Edward-benjamin/Nautilius/Fisico/20251203_213424.jpg

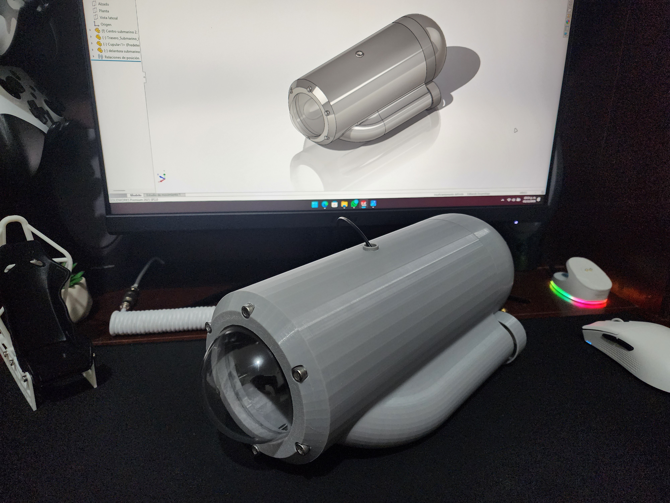
Fisico/20251203_213424.jpg
