Edward-benjamin/Nautilius/Fisico/20251203_213404.jpg

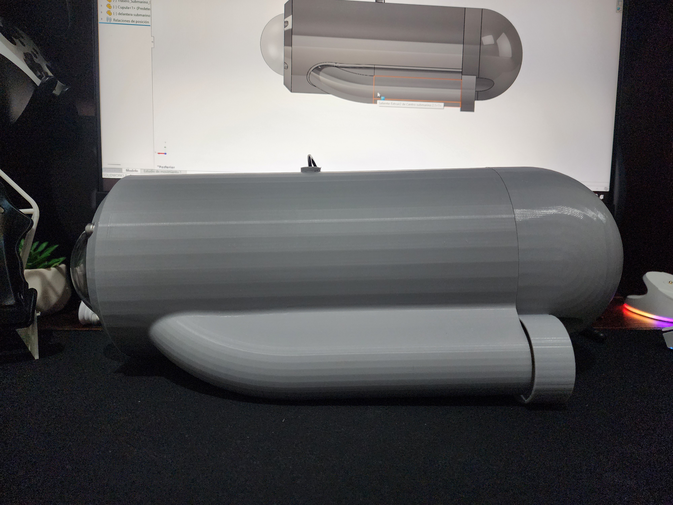
Fisico/20251203_213404.jpg
