Edward-benjamin/Nautilius/Fisico/20251203_213411.jpg

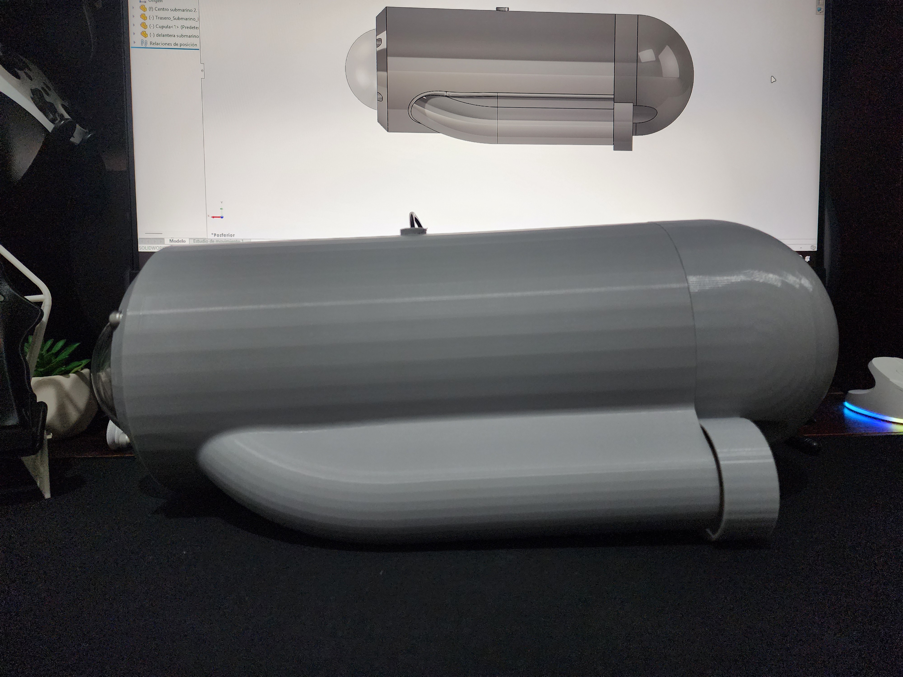
Fisico/20251203_213411.jpg
