Edward-benjamin/Nautilius/Diseño 3D/Submarino completo 4.0.SLDASM

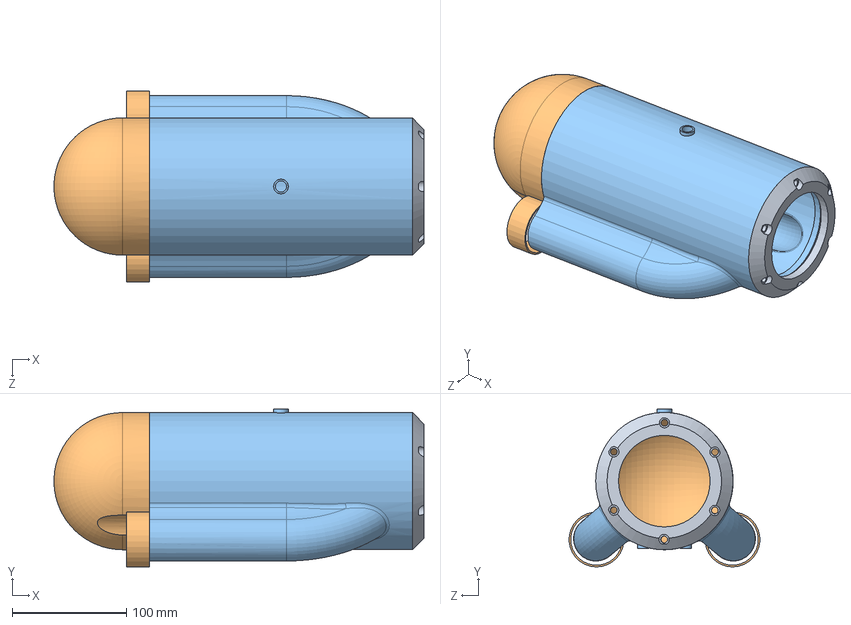
[picture p5: CAD file, 2025-12-01]
Diseño 3D/Submarino completo 4.0.SLDASM
323.4 x 138.0 x 166.8 mm
Centro submarino 2.1
Trasero_Submarino_R3
delantera submarino
