Edward-benjamin/Nautilius/Diseño 3D/Soporte medio de jeringas 2.SLDPRT

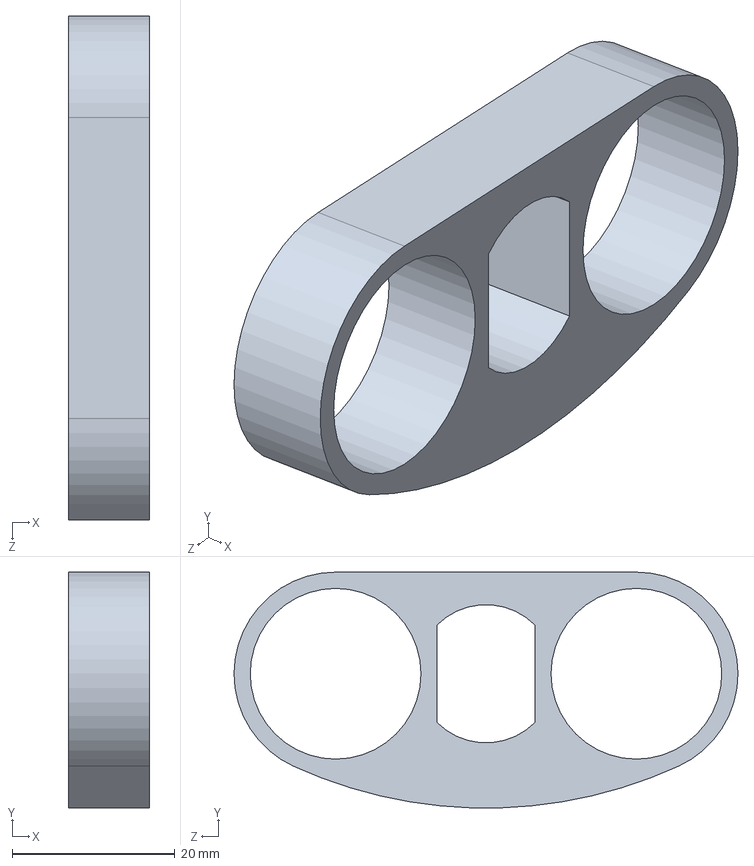
[picture p6: CAD file, 2025-12-01]
Diseño 3D/Soporte medio de jeringas 2.SLDPRT
10.0 x 29.0 x 62.0 mm
