Edward-benjamin/Nautilius/Impresión 3D/Submarino completo 4.0 - delantera submarino-1.STL

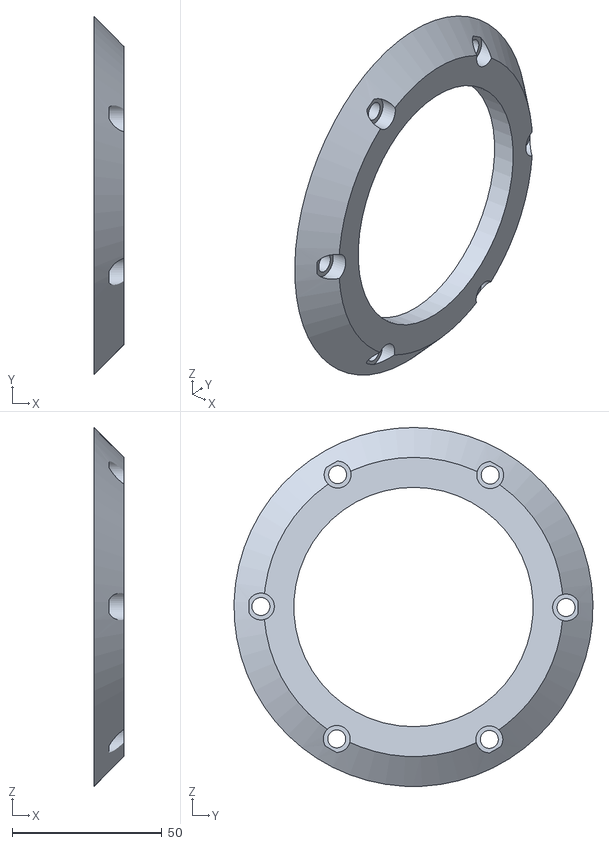
[picture p7: CAD file, 2025-12-04]
Impresión 3D/Submarino completo 4.0 - delantera submarino-1.STL
10.0 x 120.0 x 120.0
