Edward-benjamin/Nautilius/Impresión 3D/Centro submarino 2.1.STL

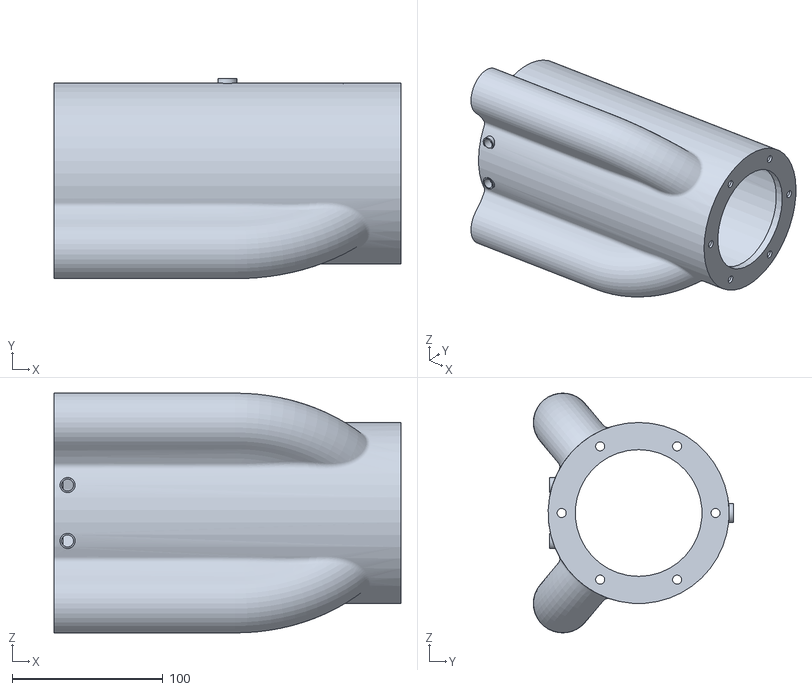
[picture p8: CAD file, 2025-12-04]
Impresión 3D/Centro submarino 2.1.STL
230.0 x 132.8 x 158.9
