Edward-benjamin/Nautilius/Impresión 3D/Submarino completo 4.0 - Trasero_Submarino_R3-1.STL

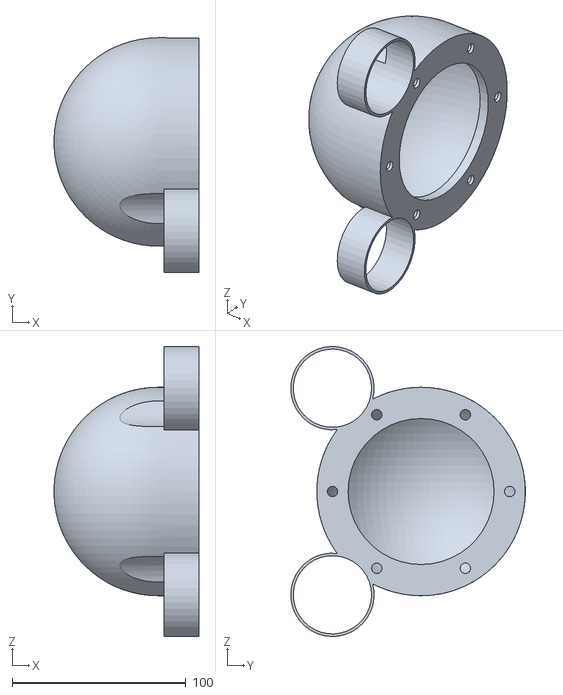
[picture p9: CAD file, 2025-12-04]
Impresión 3D/Submarino completo 4.0 - Trasero_Submarino_R3-1.STL
83.4 x 134.9 x 166.9
