Edward-benjamin/Nautilius/Diseño 3D/Submarino completo.SLDPRT

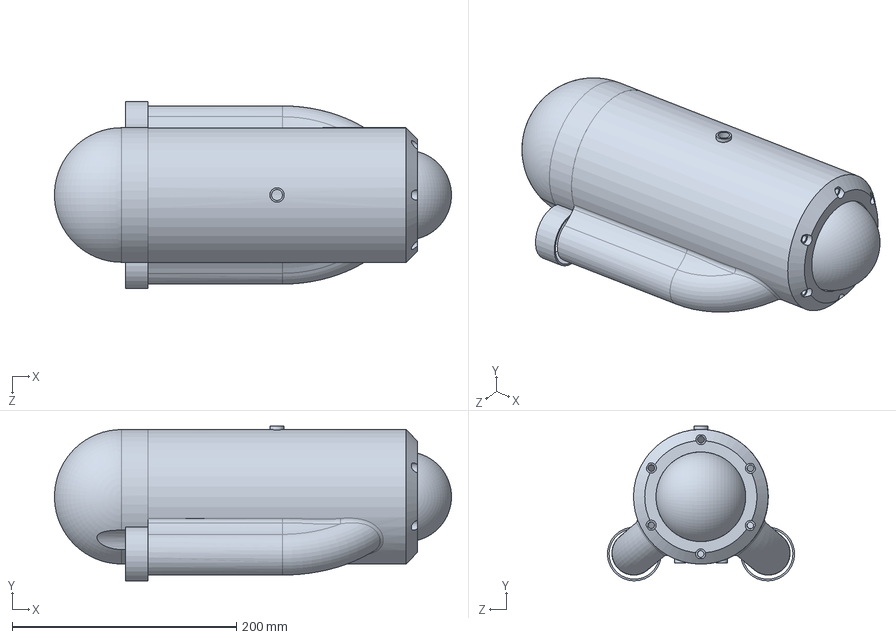
[picture p10: CAD file, 2025-12-01]
Diseño 3D/Submarino completo.SLDPRT
353.9 x 138.0 x 166.8 mm
