Edward-benjamin/Nautilius/(list of files, cad)

Other CAD files:
Diseño 3D/delantera submarino.SLDPRT
Diseño 3D/Trasero_Submarino_R3.SLDPRT
Diseño 3D/Centro submarino 2.1.SLDPRT
Diseño 3D/Submarino completo.SLDDRW
