Edward-benjamin/Nautilius/Diseño 3D/Submarino completo.pdf

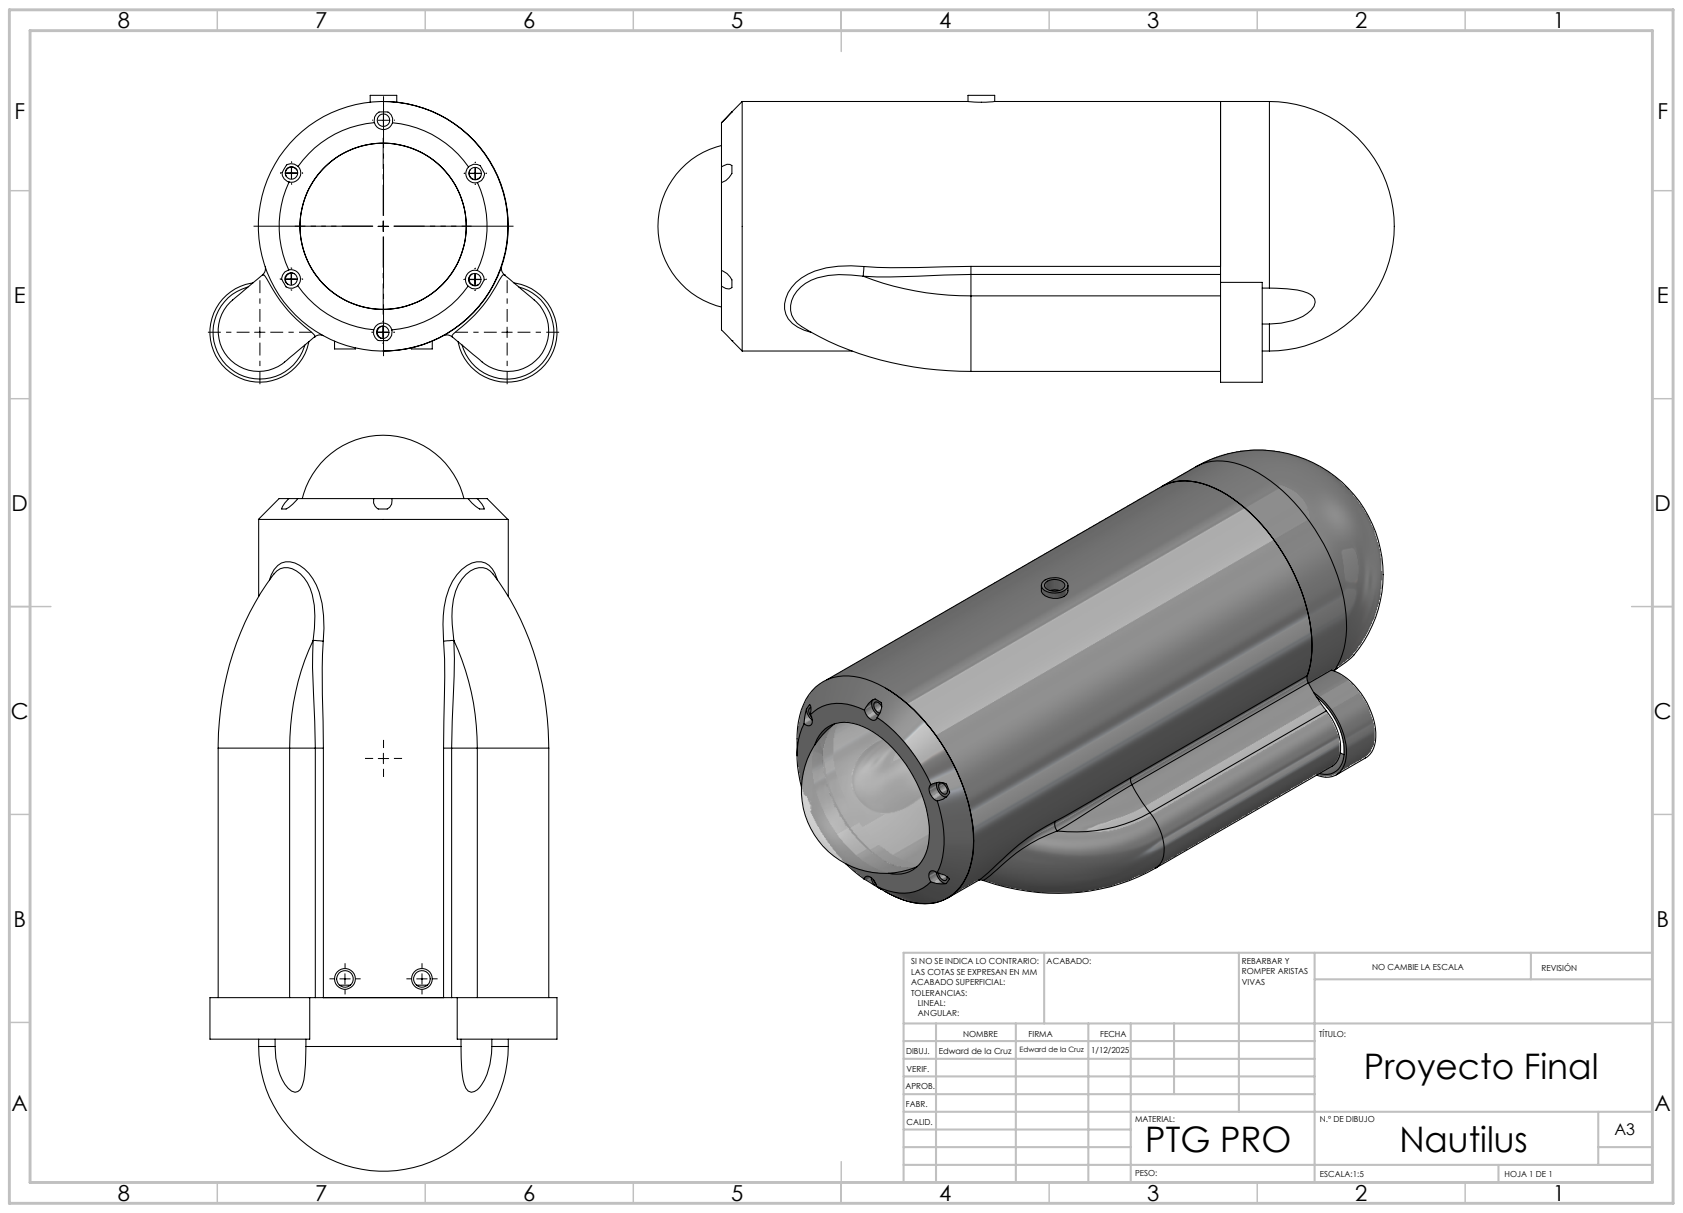
[picture p11: page 1]
ACABADO:; REBARBAR Y; ROMPER ARISTAS; NO CAMBIE LA ESCALA; REVISIÓN; ESCALA:1:5; HOJA 1 DE 1

SI NO SE INDICA LO CONTRARIO:
LAS COTAS SE EXPRESAN EN MM
ACABADO SUPERFICIAL:
TOLERANCIAS:
LINEAL:
ANGULAR:

NOMBRE | FIRMA | FECHA | | | | TÍTULO:

DIBUJ. | Edward de la Cruz | | 1/12/2025 | | | | Proyecto Final Edward de la Cruz

VERIF.
APROB.
FABR.
CALID. | | | | MATERIAL: PTG PRO | N.º DE DIBUJO Nautilus | A3
