Edward-benjamin/Nautilius/PCB/Submarino.kicad_pcb

## KiCad design PCB/Submarino.kicad_pcb (2025-12-01)

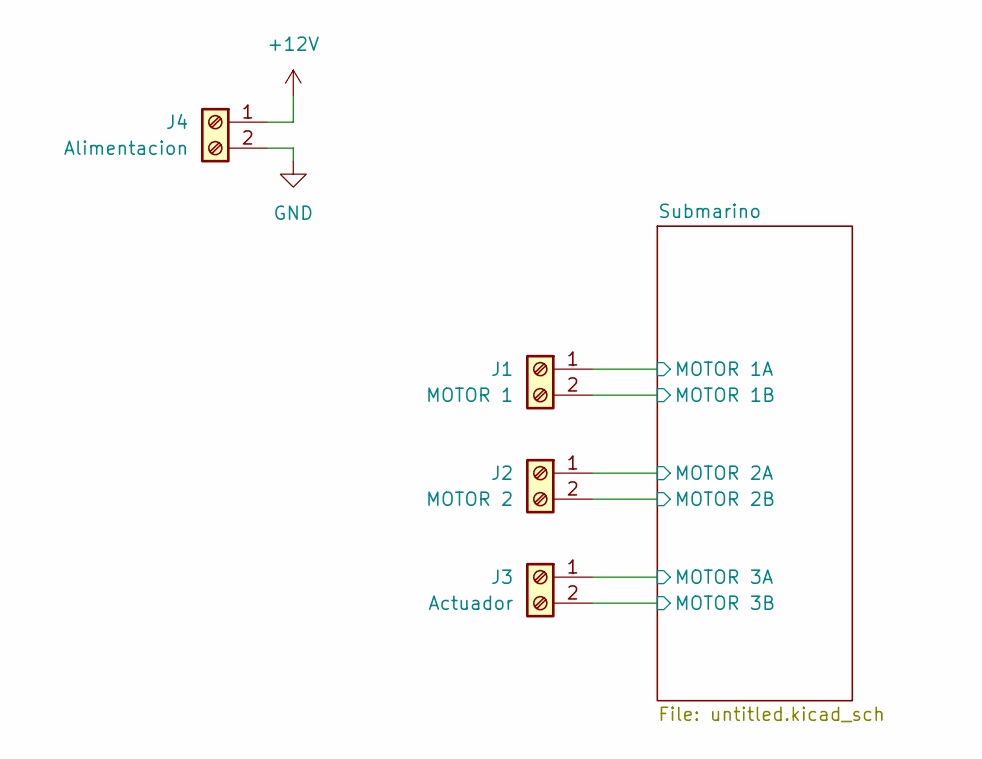
[picture p12: schematic Submarino.kicad_sch]

Parts:
J1: MOTOR 1; Molex_KK-254_AE-6410-02A_1x02_P2.54mm_Vertical
J2: MOTOR 2; Molex_KK-254_AE-6410-02A_1x02_P2.54mm_Vertical
J3: Actuador; Molex_KK-254_AE-6410-02A_1x02_P2.54mm_Vertical
J4: Alimentacion; Molex_KK-254_AE-6410-02A_1x02_P2.54mm_Vertical

Connections:
+12V: J4.1; also elsewhere on the board
/Submarino/MOTOR 1A: J1.1; also elsewhere on the board
/Submarino/MOTOR 1B: J1.2; also elsewhere on the board
/Submarino/MOTOR 2A: J2.1; also elsewhere on the board
/Submarino/MOTOR 2B: J2.2; also elsewhere on the board
/Submarino/MOTOR 3A: J3.1; also elsewhere on the board
/Submarino/MOTOR 3B: J3.2; also elsewhere on the board
GND: J4.2; also elsewhere on the board

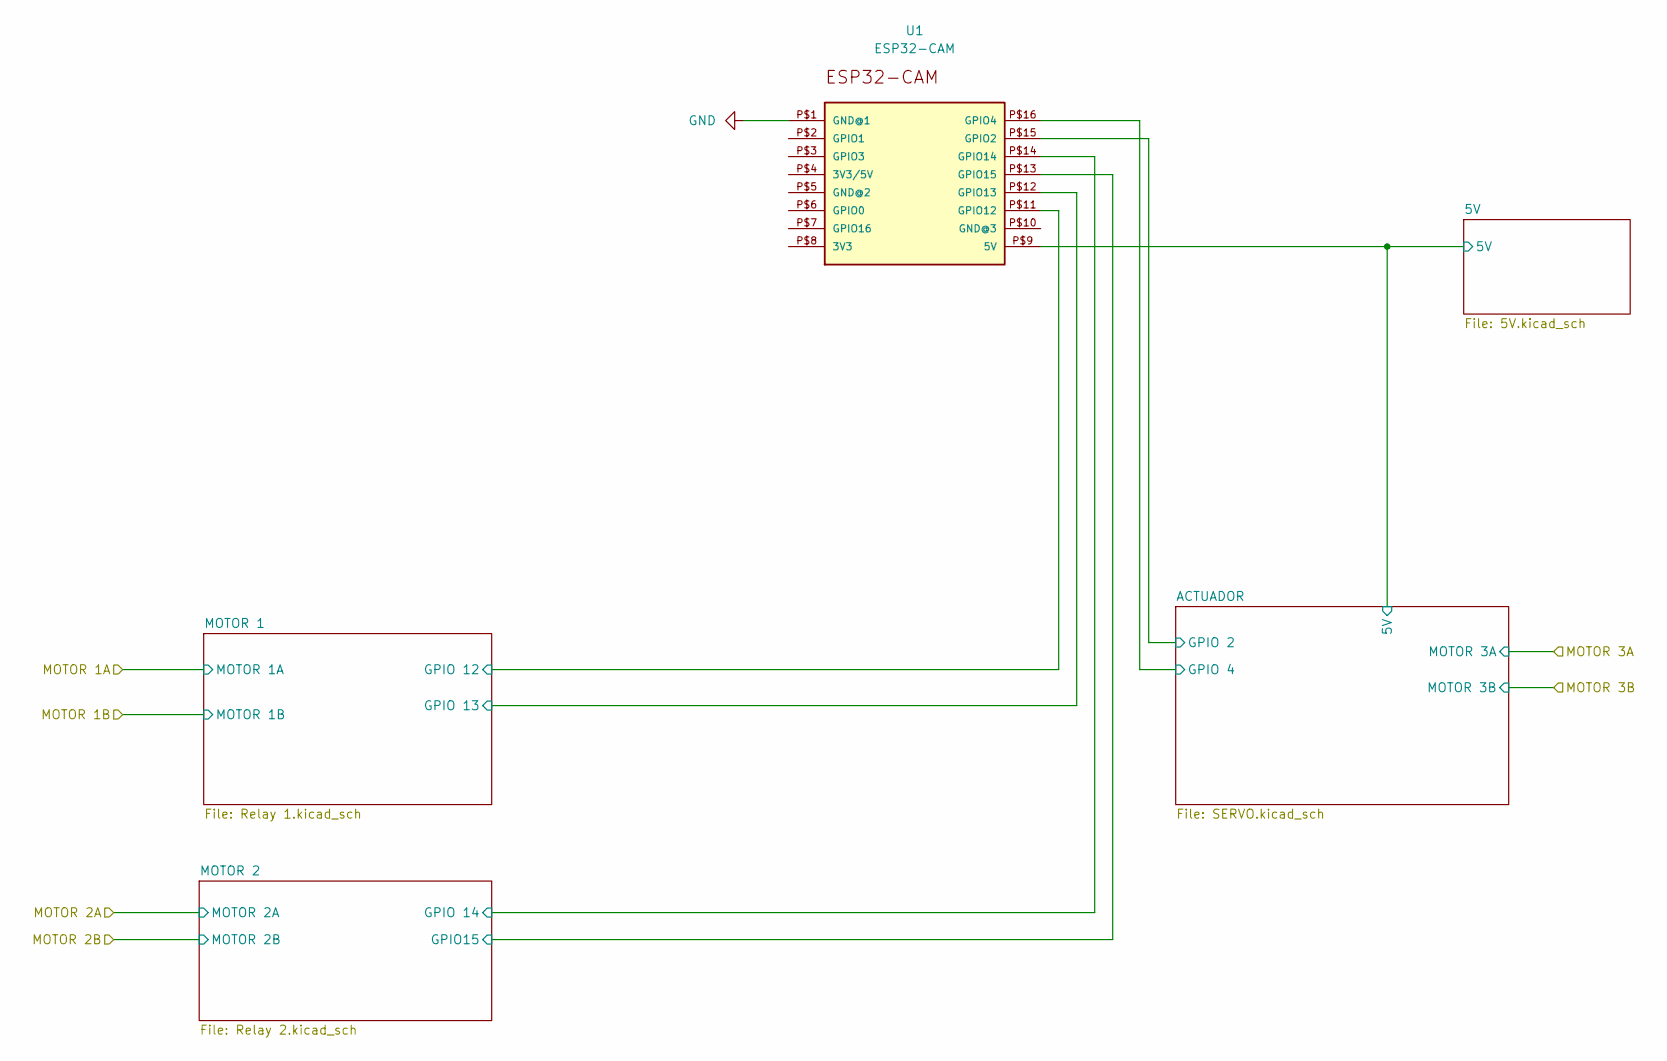
[picture p13: schematic untitled.kicad_sch]

Parts:
U1: ESP32-CAM

Connections:
/Submarino/5V/5V: U1.P$9 (5V); also elsewhere on the board
/Submarino/ACTUADOR/GPIO 2: U1.P$15 (GPIO2); also elsewhere on the board
/Submarino/ACTUADOR/GPIO 4: U1.P$16 (GPIO4); also elsewhere on the board
/Submarino/MOTOR 1/GPIO 12: U1.P$11 (GPIO12); also elsewhere on the board
/Submarino/MOTOR 1/GPIO 13: U1.P$12 (GPIO13); also elsewhere on the board
/Submarino/MOTOR 2/GPIO15: U1.P$13 (GPIO15); also elsewhere on the board
/Submarino/MOTOR 2/GPIO 14: U1.P$14 (GPIO14); also elsewhere on the board
GND: U1.P$1 (GND@1); also elsewhere on the board

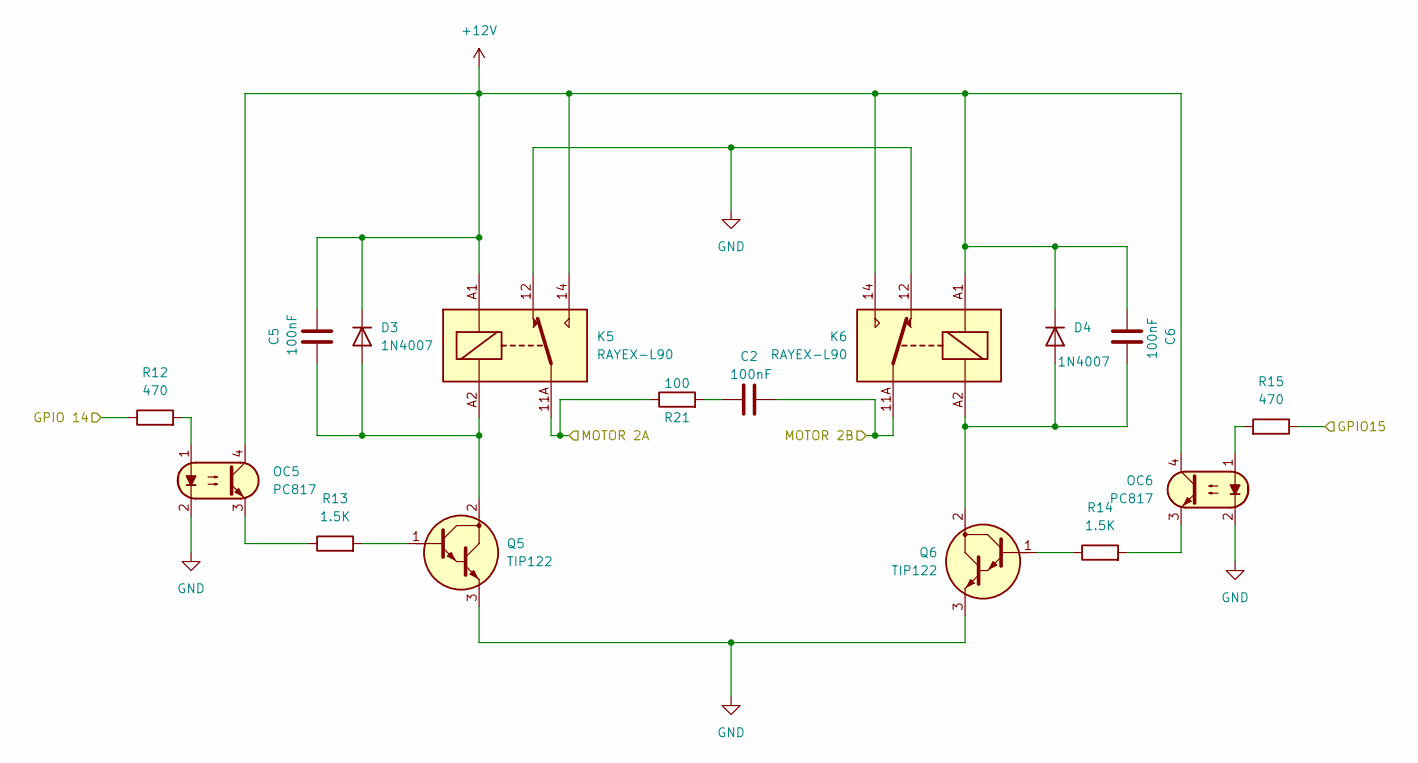
[picture p14: schematic Relay 2.kicad_sch]

Parts:
C2, C5, C6: 100nF; C_Disc_D4.3mm_W1.9mm_P5.00mm
D3, D4: 1N4007; D_DO-41_SOD81_P10.16mm_Horizontal
K5, K6: RAYEX-L90; Relay_SPDT_RAYEX-L90
OC5, OC6: PC817; DIP-4_W7.62mm_LongPads
Q5, Q6: TIP122; TO-220-3_Vertical_BCE
R12, R15: 470; R_Axial_DIN0207_L6.3mm_D2.5mm_P10.16mm_Horizontal
R13, R14: 1.5K; R_Axial_DIN0207_L6.3mm_D2.5mm_P10.16mm_Horizontal
R21: 100; R_Axial_DIN0207_L6.3mm_D2.5mm_P10.16mm_Horizontal

Connections:
+12V: C5.2, C6.1, D3.1 (K), D4.1 (K), K5.14, K5.A1, K6.14, K6.A1, OC5.4, OC6.4; also elsewhere on the board
/Submarino/MOTOR 2/GPIO15: R15.1; also elsewhere on the board
/Submarino/MOTOR 2/GPIO 14: R12.1; also elsewhere on the board
/Submarino/MOTOR 2A: K5.11A, K5.11B, R21.1; also elsewhere on the board
/Submarino/MOTOR 2B: C2.2, K6.11A, K6.11B; also elsewhere on the board
GND: K5.12, K6.12, OC5.2, OC6.2, Q5.3 (E), Q6.3 (E); also elsewhere on the board
unnamed: C2.1, R21.2
unnamed: C5.1, D3.2 (A), K5.A2, Q5.2 (C)
unnamed: C6.2, D4.2 (A), K6.A2, Q6.2 (C)
unnamed: OC5.1, R12.2
unnamed: OC5.3, R13.1
unnamed: OC6.1, R15.2
unnamed: OC6.3, R14.2
unnamed: Q5.1 (B), R13.2
unnamed: Q6.1 (B), R14.1

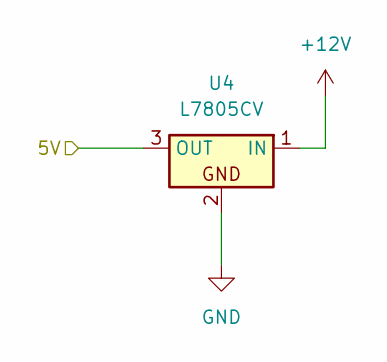
[picture p15: schematic 5V.kicad_sch]

Parts:
U4: L7805CV; TO-220-3_Vertical

Connections:
+12V: U4.1 (IN); also elsewhere on the board
/Submarino/5V/5V: U4.3 (OUT); also elsewhere on the board
GND: U4.2; also elsewhere on the board

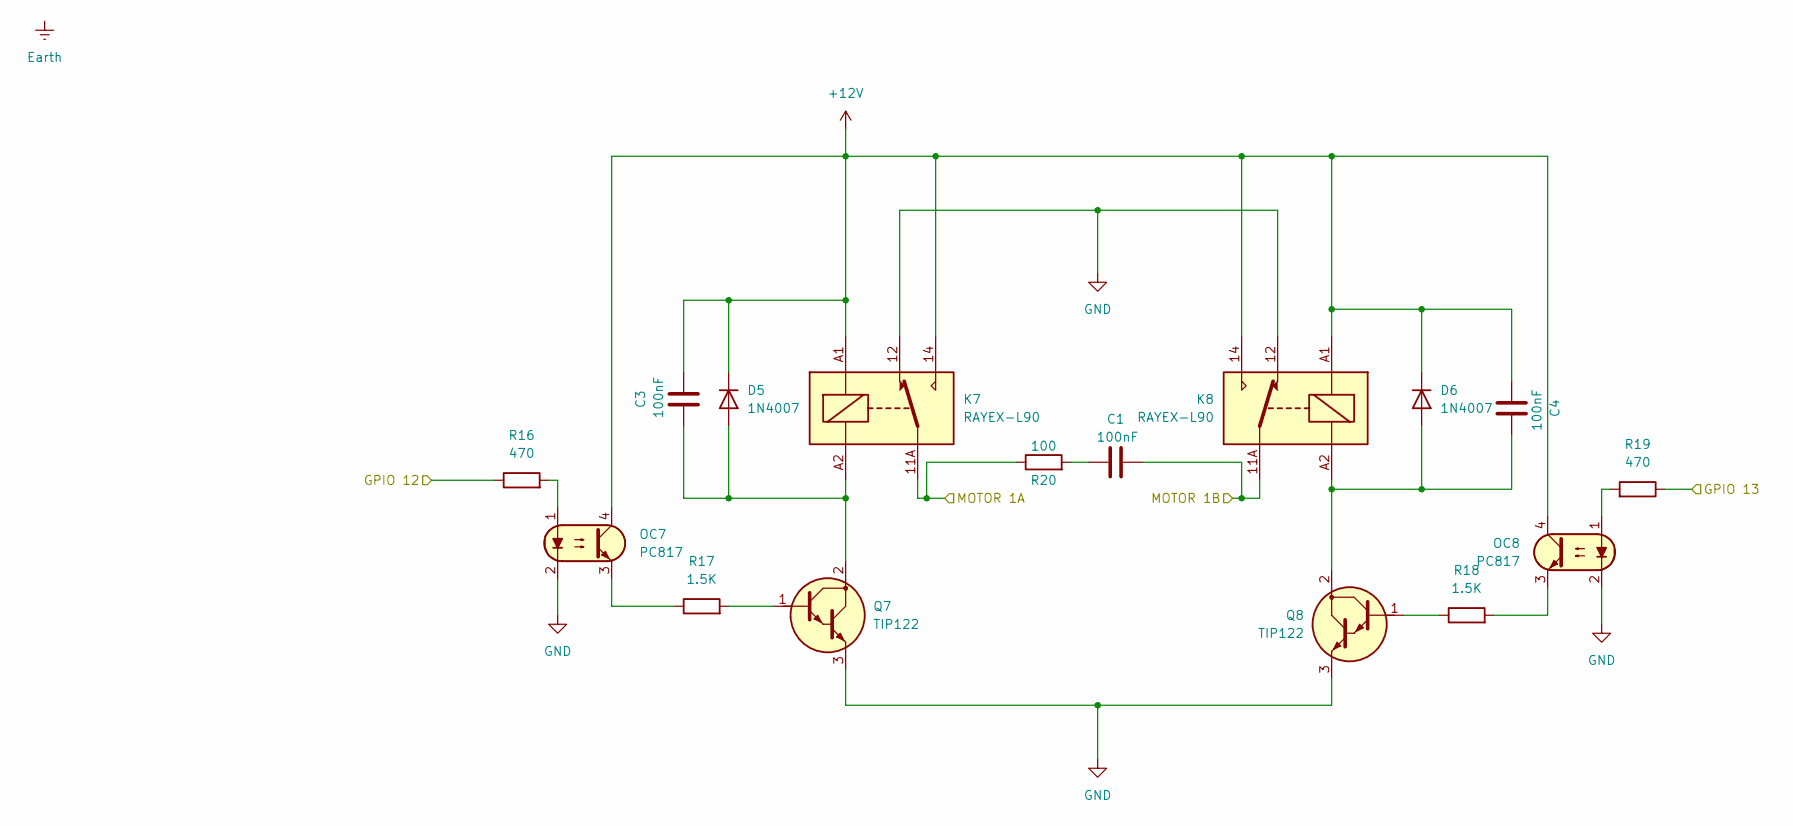
[picture p16: schematic Relay 1.kicad_sch]

Parts:
C1, C3, C4: 100nF; C_Disc_D4.3mm_W1.9mm_P5.00mm
D5, D6: 1N4007; D_DO-41_SOD81_P10.16mm_Horizontal
K7, K8: RAYEX-L90; Relay_SPDT_RAYEX-L90
OC7, OC8: PC817; DIP-4_W7.62mm_LongPads
Q7, Q8: TIP122; TO-220-3_Vertical_BCE
R16, R19: 470; R_Axial_DIN0207_L6.3mm_D2.5mm_P10.16mm_Horizontal
R17, R18: 1.5K; R_Axial_DIN0207_L6.3mm_D2.5mm_P10.16mm_Horizontal
R20: 100; R_Axial_DIN0207_L6.3mm_D2.5mm_P10.16mm_Horizontal

Connections:
+12V: C3.2, C4.1, D5.1 (K), D6.1 (K), K7.14, K7.A1, K8.14, K8.A1, OC7.4, OC8.4; also elsewhere on the board
/Submarino/MOTOR 1/GPIO 12: R16.1; also elsewhere on the board
/Submarino/MOTOR 1/GPIO 13: R19.1; also elsewhere on the board
/Submarino/MOTOR 1A: K7.11A, K7.11B, R20.1; also elsewhere on the board
/Submarino/MOTOR 1B: C1.2, K8.11A, K8.11B; also elsewhere on the board
GND: K7.12, K8.12, OC7.2, OC8.2, Q7.3 (E), Q8.3 (E); also elsewhere on the board
unnamed: C1.1, R20.2
unnamed: C3.1, D5.2 (A), K7.A2, Q7.2 (C)
unnamed: C4.2, D6.2 (A), K8.A2, Q8.2 (C)
unnamed: OC7.1, R16.2
unnamed: OC7.3, R17.1
unnamed: OC8.1, R19.2
unnamed: OC8.3, R18.2
unnamed: Q7.1 (B), R17.2
unnamed: Q8.1 (B), R18.1

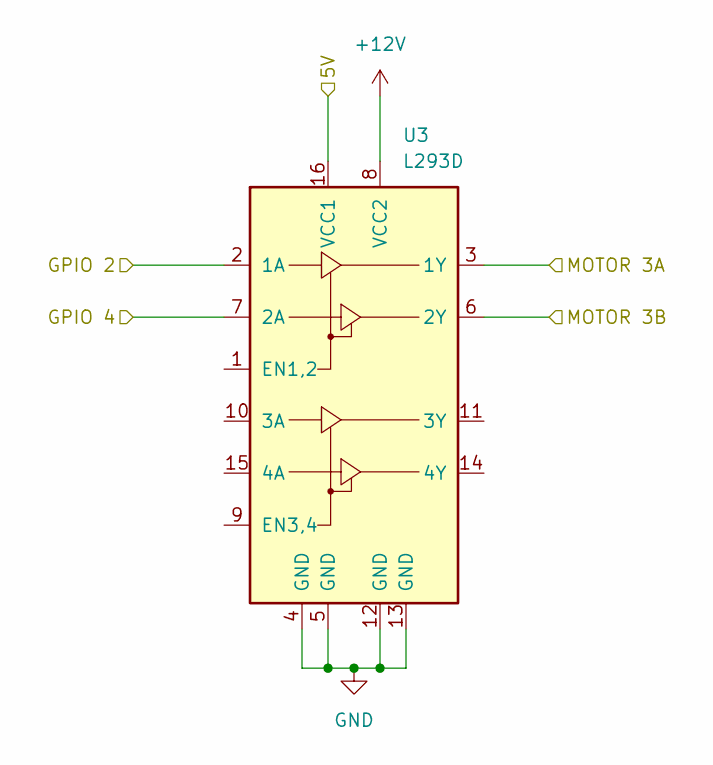
[picture p17: schematic SERVO.kicad_sch]

Parts:
U3: L293D; DIP-16_W7.62mm

Connections:
+12V: U3.8 (VCC2); also elsewhere on the board
/Submarino/5V/5V: U3.16 (VCC1); also elsewhere on the board
/Submarino/ACTUADOR/GPIO 2: U3.2 (1A); also elsewhere on the board
/Submarino/ACTUADOR/GPIO 4: U3.7 (2A); also elsewhere on the board
/Submarino/MOTOR 3A: U3.3 (1Y); also elsewhere on the board
/Submarino/MOTOR 3B: U3.6 (2Y); also elsewhere on the board
GND: U3.4 (GND), U3.5 (GND), U3.12 (GND), U3.13 (GND); also elsewhere on the board

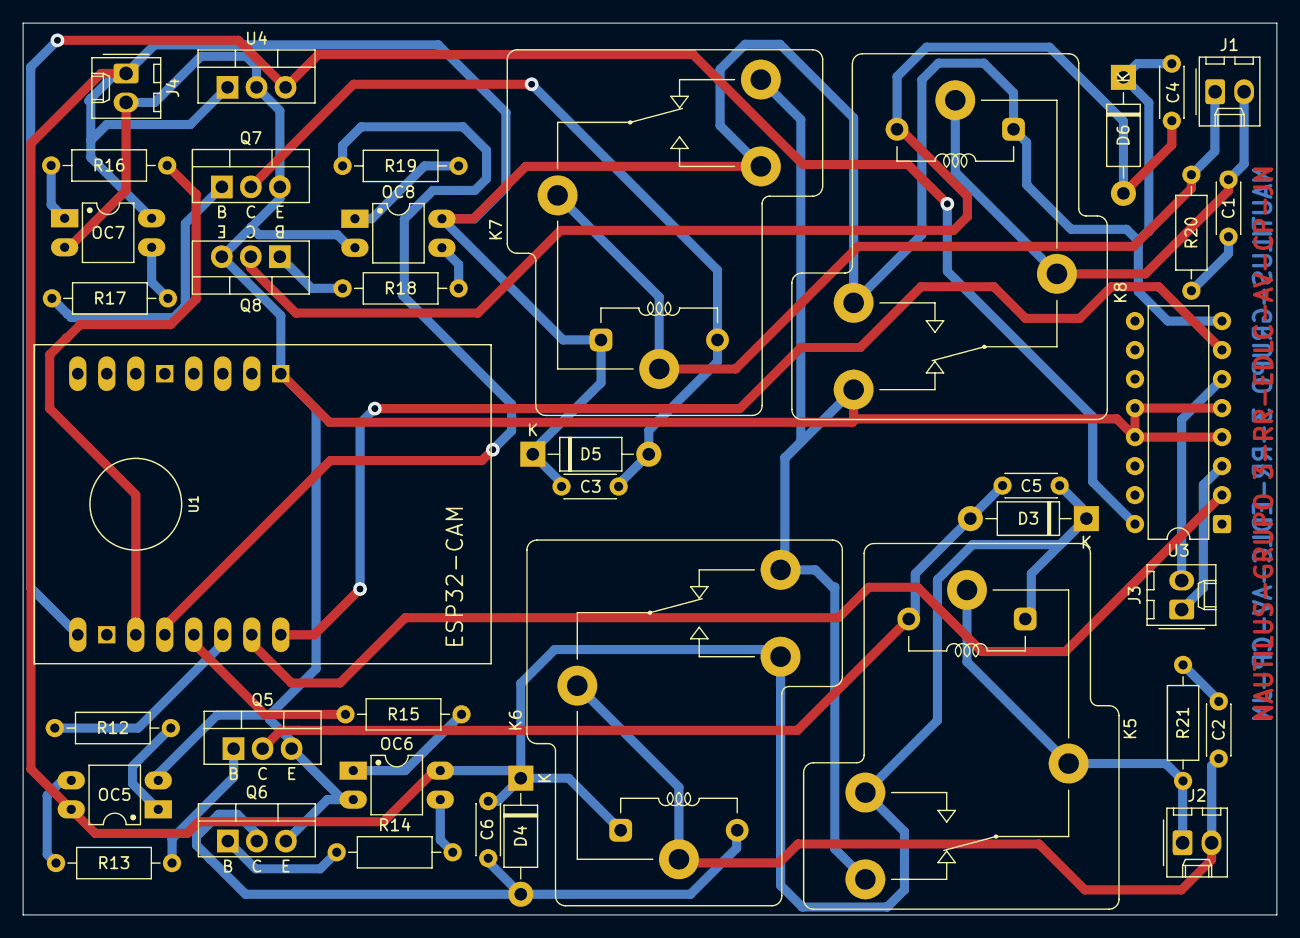
[picture p18: board Submarino.kicad_pcb from above]

Board: 2 copper layers, 109.8 x 78.1 mm, 39 parts (0 on the bottom side), 33 nets.
