Edward-benjamin/Nautilius/Fisico/20251203_213350.jpg

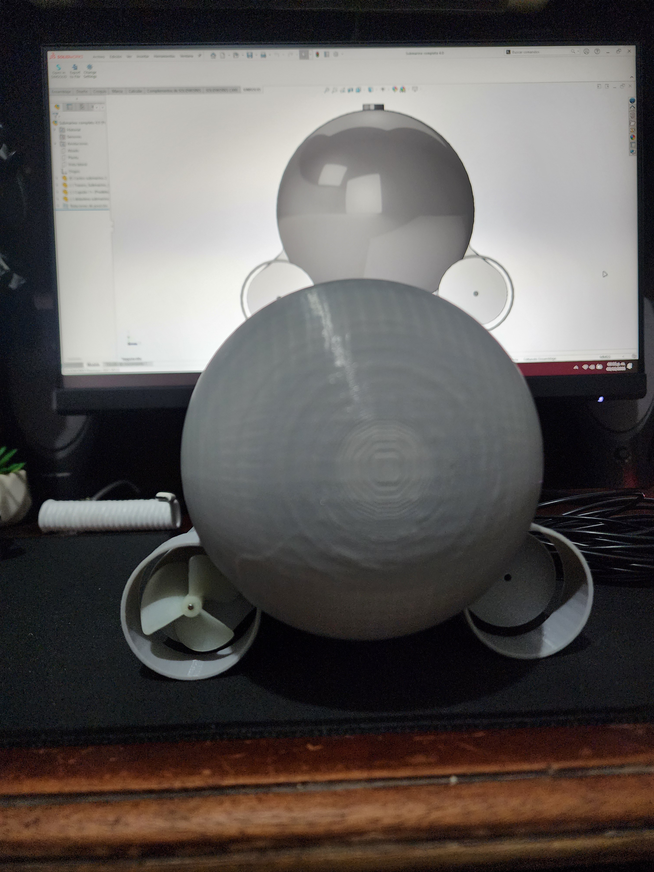
Fisico/20251203_213350.jpg
